Josh-zoo/ENGG3000-WhackAMole/ryan-mole-game/SensorF/old/README.md

# Old firmware (not used)

Earlier versions kept for reference only. They are renamed to `.txt` so the
Arduino IDE never compiles them by accident (Arduino merges every `.ino` in a
folder into one program, which caused "redefinition" errors).

Use `SensorF_WiFi/` (box 1, hub) and `SensorF_Node/` (box 2, node) instead.
