Josh-zoo/ENGG3000-WhackAMole/hardware/enclosure/RIGHT_S3-S4_lid.stl

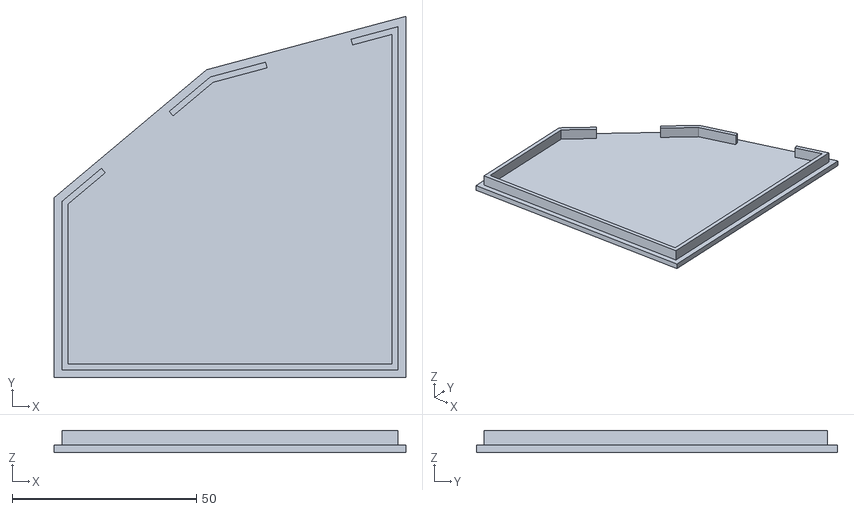
[picture p1: CAD file, 2026-10-19]
hardware/enclosure/RIGHT_S3-S4_lid.stl
95.5 x 98.0 x 6.00
