Josh-zoo/ENGG3000-WhackAMole/ryan-mole-game/results/predicted_per_cell.csv

cell | v1_fix_rate | v1_tri_rate | v1_median_err | v1_p95_err | v1_cell_correct | v2_fix_rate | v2_tri_rate | v2_median_err | v2_p95_err | v2_cell_correct
A1 | 95.8 | 85.0 | 11.5 | 31.5 | 86.7 | 90.8 | 90.8 | 7.7 | 27.7 | 95.0
B1 | 1.7 | 0.0 | 72.1 | 72.3 | 0.0 | 11.7 | 0.0 | 29.9 | 30.4 | 32.5
C1 | 0.0 | 0.0 |  |  | 0.0 | 92.5 | 92.5 | 9.1 | 27.9 | 91.7
A2 | 94.2 | 0.0 | 25.1 | 25.7 | 96.7 | 100.0 | 0.0 | 30.4 | 30.5 | 0.0
B2 | 95.0 | 86.7 | 20.1 | 77.6 | 56.7 | 100.0 | 100.0 | 1.0 | 2.2 | 100.0
C2 | 0.0 | 0.0 |  |  | 0.0 | 100.0 | 0.0 | 30.4 | 30.5 | 0.0
A3 | 0.0 | 0.0 |  |  | 0.0 | 53.3 | 53.3 | 26.4 | 64.6 | 55.8
B3 | 97.5 | 95.8 | 30.1 | 76.6 | 43.3 | 100.0 | 100.0 | 0.9 | 2.1 | 100.0
C3 | 93.3 | 88.3 | 39.2 | 130.6 | 42.5 | 50.8 | 50.8 | 19.1 | 60.8 | 66.7
ALL | 53.1 | 39.5 | 25.2 | 79.1 | 36.2 | 77.7 | 54.2 | 15.9 | 43.3 | 60.2
