Josh-zoo/ENGG3000-WhackAMole/ryan-mole-game/SensorF/SensorF_WiFi/ESP32_2_Node.ino

#include <Arduino.h>
#include <WiFi.h>
#include <esp_now.h>

// Remote Sensor Pins (S3 & S4)
const int TRIG_PIN_3 = 25; 
const int ECHO_PIN_3 = 26; 
const int TRIG_PIN_4 = 27; 
const int ECHO_PIN_4 = 14; 

const unsigned long ECHO_TIMEOUT = 30000; // 30 ms

// REPLACE THIS WITH THE MAC ADDRESS PRINTED BY ESP32 #1
// Format is: {0x00, 0x00, 0x00, 0x00, 0x00, 0x00}
uint8_t hubAddress[] = {0xFF, 0xFF, 0xFF, 0xFF, 0xFF, 0xFF}; 

typedef struct struct_message {
    float distance3;
    float distance4;
} struct_message;
struct_message myData;

esp_now_peer_info_t peerInfo;

float measureDistanceCM(int trigPin, int echoPin) {
  digitalWrite(trigPin, LOW);
  delayMicroseconds(2);
  digitalWrite(trigPin, HIGH);
  delayMicroseconds(10);
  digitalWrite(trigPin, LOW);

  unsigned long duration = pulseIn(echoPin, HIGH, ECHO_TIMEOUT);
  if (duration == 0) return -1.0;
  return duration * 0.0343 / 2.0;
}

void setup() {
  Serial.begin(115200);
  delay(1000);

  pinMode(TRIG_PIN_3, OUTPUT);
  pinMode(ECHO_PIN_3, INPUT);
  pinMode(TRIG_PIN_4, OUTPUT);
  pinMode(ECHO_PIN_4, INPUT);
  digitalWrite(TRIG_PIN_3, LOW);
  digitalWrite(TRIG_PIN_4, LOW);

  // Set device as a Wi-Fi Station
  WiFi.mode(WIFI_STA);

  // Initialize ESP-NOW
  if (esp_now_init() != ESP_OK) {
    Serial.println("Error initializing ESP-NOW");
    return;
  }

  // Register peer
  memcpy(peerInfo.peer_addr, hubAddress, 6);
  peerInfo.channel = 0; // Use current Wi-Fi channel
  peerInfo.encrypt = false;
  
  if (esp_now_add_peer(&peerInfo) != ESP_OK){
    Serial.println("Failed to add peer");
    return;
  }
}

void loop() {
  // Read remote sensors with 60ms stagger
  myData.distance3 = measureDistanceCM(TRIG_PIN_3, ECHO_PIN_3);
  delay(60);
  myData.distance4 = measureDistanceCM(TRIG_PIN_4, ECHO_PIN_4);
  
  // Send message via ESP-NOW
  esp_err_t result = esp_now_send(hubAddress, (uint8_t *) &myData, sizeof(myData));
   
  if (result == ESP_OK) {
    Serial.println("Sent S3/S4 successfully");
  } else {
    Serial.println("Error sending data");
  }
  
  delay(100);
}
