Josh-zoo/ENGG3000-WhackAMole/(commit log)

2026-08-03 Whack-A-Mole Functionality Program
    Basic interface that demonstrates the core game loop, having functionalities like increasing game speed (time to get to mole), points, levels. Does not incorporate sensor/person interaction
2026-08-18 Game Functionality w/ Sensor and Wireless Connection
2026-08-18 Triangulation two-column game + table-scale test mode for Assessment 1
    Two sensors on a known baseline trilaterate the player position:
    x = (r1^2 - r2^2 + B^2)/2B, y = sqrt(r1^2 - x^2). Triangulated x
    picks the box (2 columns) with hysteresis; single-echo falls back
    to that sensor's half; live fix readout drawn in the game window.
    TABLE_TEST flag selects a 1:2 tabletop rig (50 cm field, boxes at
    25-50 cm) for the Assessment 1 mini demo. Firmware sends both
    sensor ranges per packet; coverage sandbox tool included.
    Claude-Session: https://claude.ai/code/session_01SBNjRfGji2tYqoYe9r6sLS
    [SensorF_WiFi.ino, SensorInputBridge.java]
2026-09-04 Add triangulation module and update sensor integration
2026-09-08 re added timer bar
2026-09-08 Implement ESP32 UDP triangulation testing
2026-09-14 Expanded ESP32 comms to utilise 4-sensor array and integrated empirical telemetry tracking
    Expanded ESP32 pin definitions and loop logic to support staggered acoustic polling for Sensor 3 and Sensor 4. Increased UDP payload buffer to 128 bytes to accommodate larger string. Injected SequenceNumber and millis() timestamps into UDP packet format to enable PC-side empirical tracking of network latency and packet loss.
2026-09-15 separated levels with an intermission screen
    also made the timer shorter and reset every level
2026-09-23 Telemetry System with ESP-NOW
    Firmware is splint into a hub and node to ruggedise the hardware layout, implemented ESP-NOW transmission on the node to wirelessly communicate. Hub is configured as a concurretn wi-fi ap station, there is still a 60ms acoustic stagger to prevent ultrasonic crosstalk.
    > needs to be tested and ran on hardware, this includes changing mac address
    [ESP32_1_Hub.ino, ESP32_2_Node.ino]
2026-09-27 Split Arduino Code into Main and Node for the 3rd and 4th sensor
2026-09-30 4-sensor multilateration (generalises Saim's pair solver), 3x3 full-scale grid, live tracking trail, sim mode
2026-09-30 Reorganize sensor code and update 4-sensor integration
    [empirical_telemetry_V2.csv]
2026-10-01 Use Saim's measured sensor spacings (hub 8 cm, node 11 cm). Also changed sensor setup degrees to 25
2026-10-02 Add ESP32 web monitoring and calibrate sensor geometry
2026-10-05 Tracking smoothing, spike filter, measured sensor spacing
2026-10-12 Fix box 1 <-> box 2 ESP-NOW link and clean up firmware folders
    - Hub: keep radio awake (WiFi.setSleep(false)) so ESP-NOW messages
    from box 2 aren't missed; report stale S3/S4 as "No echo"; print
    channel and messages received per second; core 2.x/3.x callback.
    - Node: join the hotspot so it always shares box 1's channel (was
    hard-coded to channel 6), scan fallback, correct hub MAC via
    secrets.h, delivery ok/failed counter, radio kept awake.
    - Wi-Fi credentials, laptop IP and hub MAC moved to git-ignored
    secrets.h with secrets.example.h templates.
    - Old sketches moved to SensorF/old/ as .txt so Arduino stops
    compiling them alongside the hub (redefinition errors).
    - README: firmware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
2026-10-13 Sensor aim 15/40, test logging, V1 solver and analysis tools
2026-10-17 Sensor positions from 3D-printed boxes (S1/S4 15 deg, S2/S3 40 deg), fix build
2026-10-17 3D-printed sensor enclosures (S1/S2 and S3/S4, 15/40 deg faces)
2026-10-28 Final game: power-up moles, timed levels with day/night/sunset scenery, hammer smash animation, low-time warning, mouse test mode
2026-10-29 changed intermission page
    dont need to hold the button anymore
2026-10-29 increased sensor delay
